blendeddd/lidar-bot/stls/finallid.stl

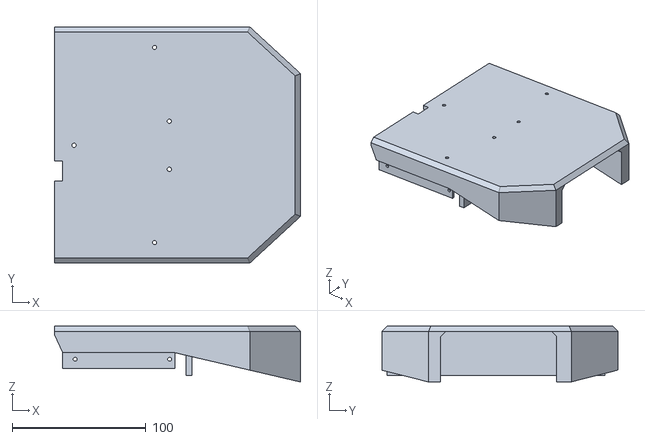
[picture p1: CAD file, 2026-09-17]
stls/finallid.stl
184.2 x 177.0 x 41.9
