blendeddd/lidar-bot/stls/finallidplaque.stl

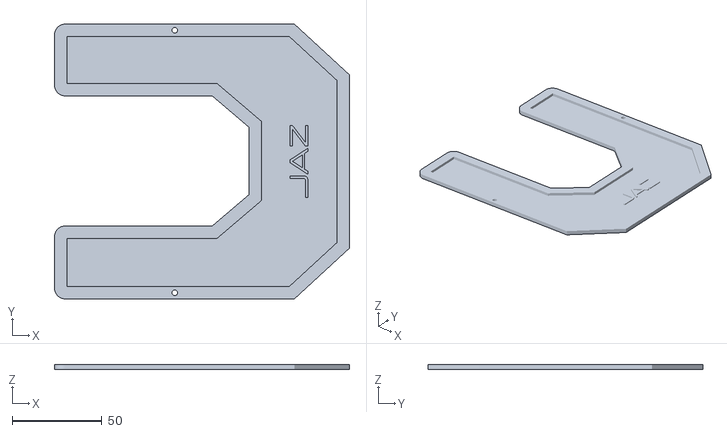
[picture p2: CAD file, 2026-09-17]
stls/finallidplaque.stl
164.2 x 153.0 x 3.00
