blendeddd/lidar-bot/stls/finalbody.stl

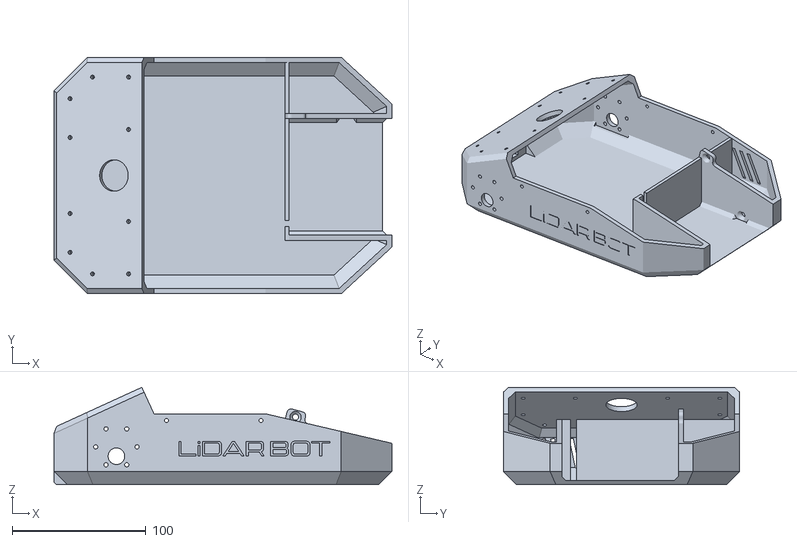
[picture p3: CAD file, 2026-09-17]
stls/finalbody.stl
253.0 x 177.0 x 72.9
