blendeddd/lidar-bot/stls/motortest6.stl

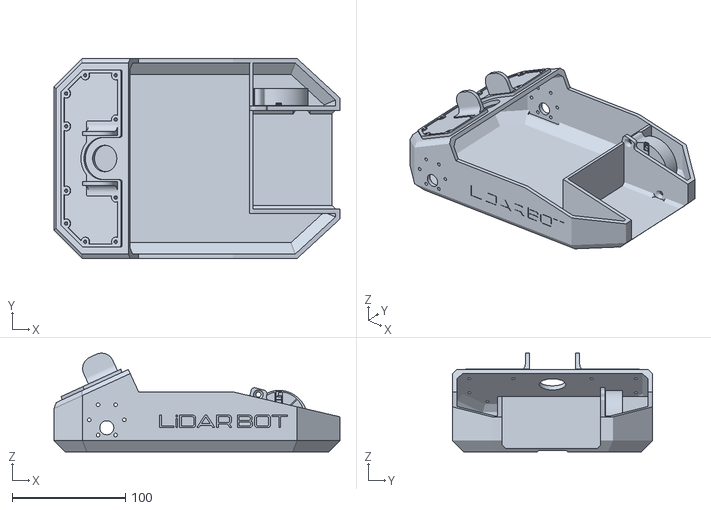
[picture p4: CAD file, 2026-09-04]
stls/motortest6.stl
253.0 x 177.0 x 87.3
