blendeddd/lidar-bot/stls/motortest5.stl

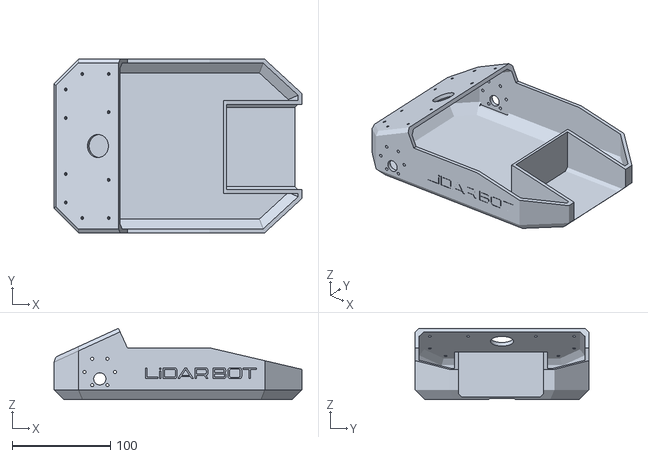
[picture p5: CAD file, 2026-09-04]
stls/motortest5.stl
253.0 x 177.0 x 72.9
