blendeddd/lidar-bot/stls/motortest2.stl

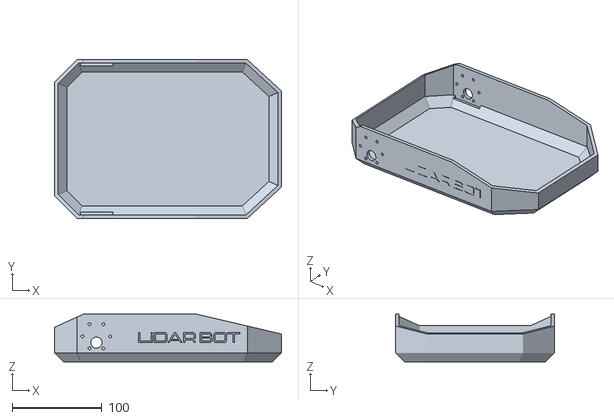
[picture p6: CAD file, 2026-09-04]
stls/motortest2.stl
253.0 x 177.0 x 53.0
