blendeddd/lidar-bot/stls/motortest1.stl

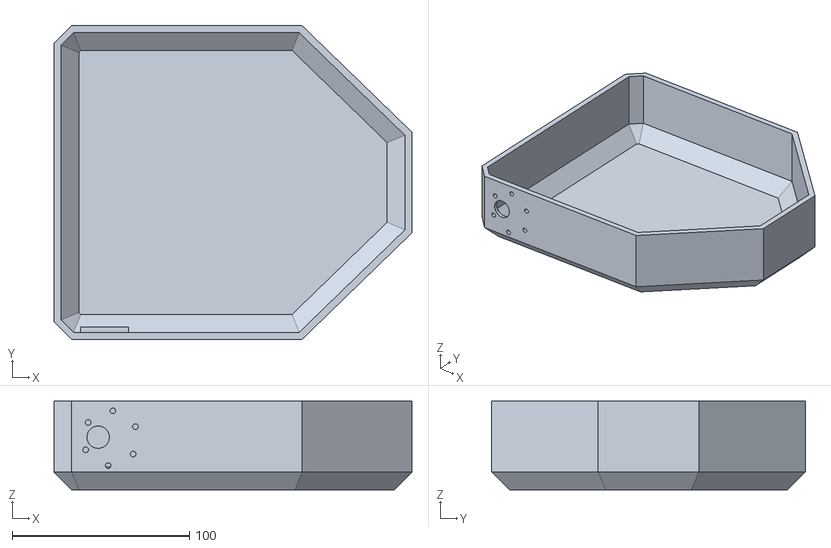
[picture p7: CAD file, 2026-09-04]
stls/motortest1.stl
202.0 x 177.0 x 50.0
