blendeddd/lidar-bot/stls/faceplate1.stl

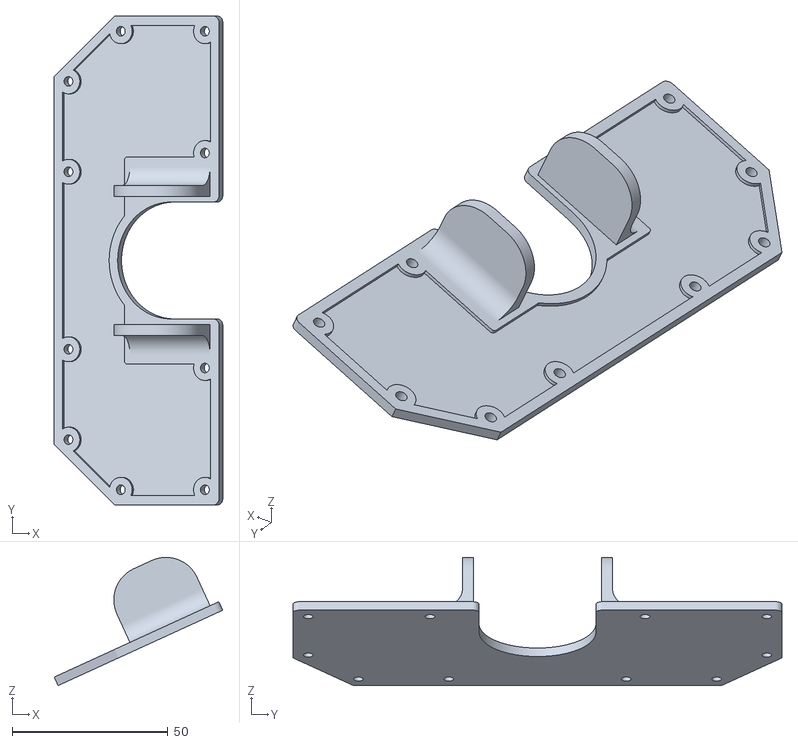
[picture p8: CAD file, 2026-09-04]
stls/faceplate1.stl
54.1 x 157.0 x 41.2
