blendeddd/lidar-bot/stls/motortest4.stl

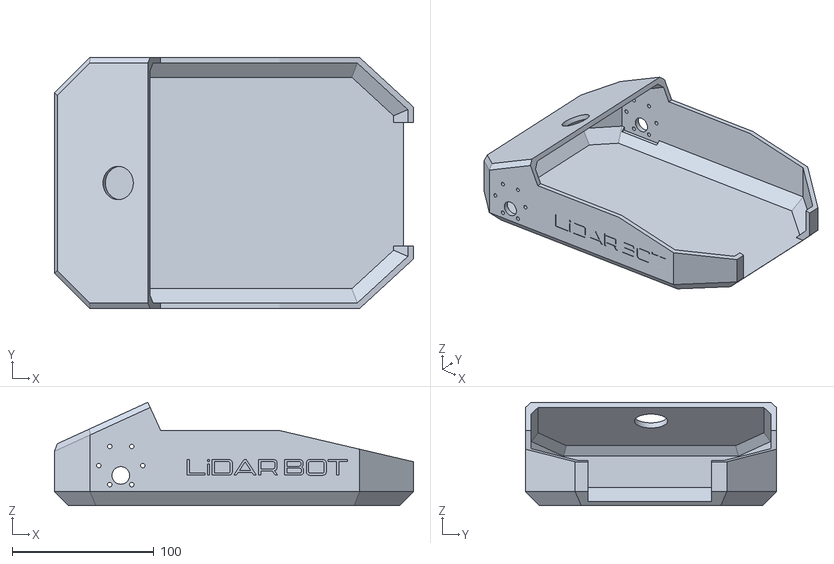
[picture p9: CAD file, 2026-09-04]
stls/motortest4.stl
253.0 x 177.0 x 72.9
