blendeddd/lidar-bot/(list of files, cad)

Other CAD files:
stls/lidtest1.stl
stls/lidtest2.stl
stls/motortest7.stl
stls/motortest8.stl
stls/motortest3.stl
