blendeddd/lidar-bot/(commit log)

2026-09-04 Draft STLS
    Updated README
    [faceplate1.stl, motortest1.stl, motortest2.stl, motortest3.stl, motortest4.stl, motortest5.stl, motortest6.stl, motortest7.stl]
2026-09-17 Final build + firmware and software
    final stls, firmware and ros2 programs
    [finalbody.stl, finallid.stl, finallidplaque.stl, lidarbot.urdf, lidtest1.stl, lidtest2.stl, motortest9.stl]
